maronmaeda/minicar_parts/CAM_MOUNT_D455_余力有版.stl

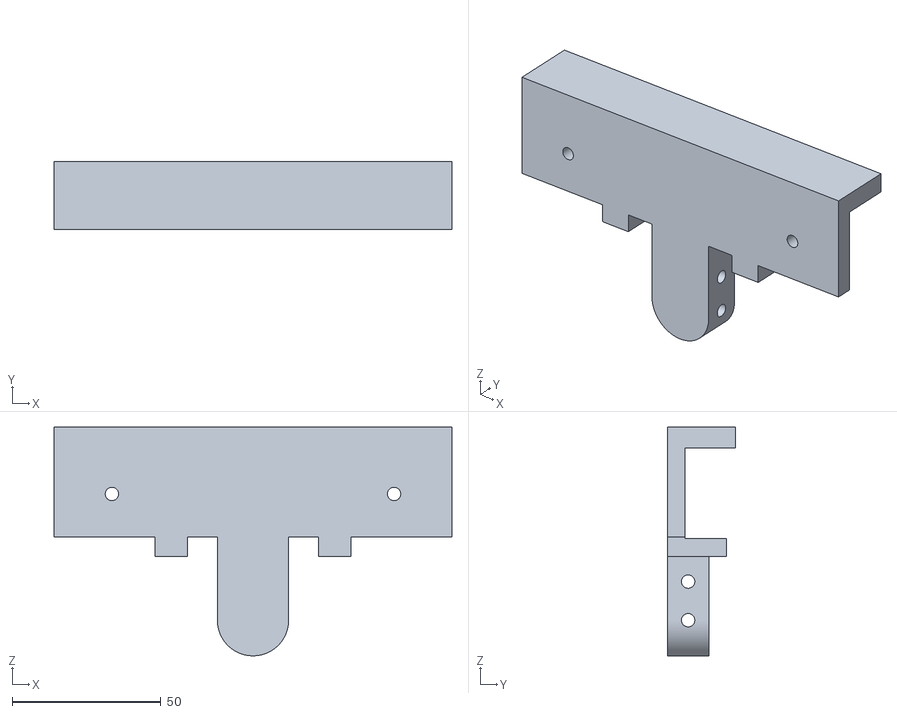
[picture p1: CAD file, 2026-09-10]
CAM_MOUNT_D455_余力有版.stl
134.0 x 23.0 x 77.0
