maronmaeda/minicar_parts/parts/01_TOWER.FCStd

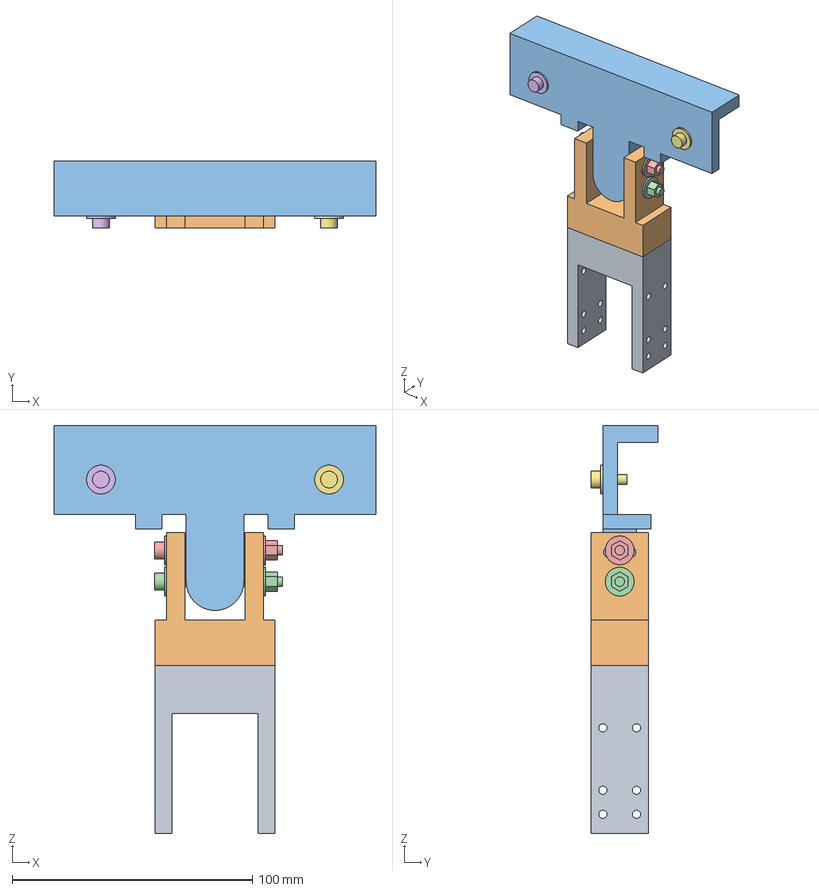
[picture p2: CAD file, 2026-09-10]
parts/01_TOWER.FCStd
134.0 x 28.0 x 169.9 mm
TOWER_タワー本体
REF_ADJUSTER_参照_印刷対象外
REF_CAM_MOUNT_参照_印刷対象外
REF_回転軸_M4x40_印刷対象外
REF_クランプ_M4x40_印刷対象外
REF_カメラ左_M4x10_印刷対象外
REF_カメラ右_M4x10_印刷対象外
