maronmaeda/minicar_parts/parts/_backup/01_TOWER.20260910-202742.FCStd

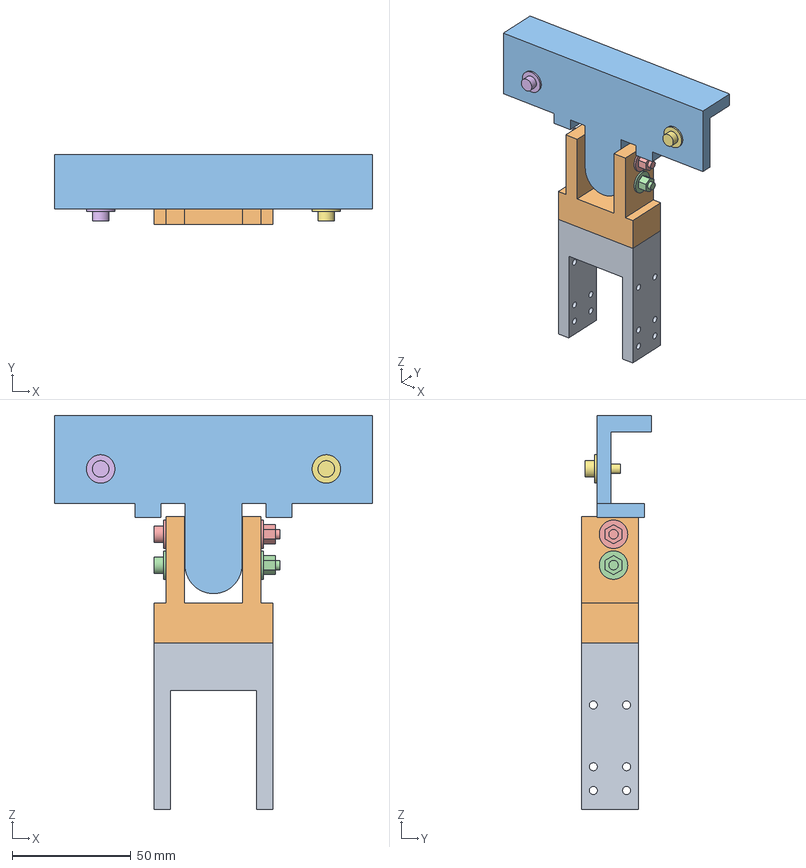
[picture p3: CAD file, 2026-09-10]
parts/_backup/01_TOWER.20260910-202742.FCStd
134.0 x 29.5 x 165.9 mm
TOWER_タワー本体
REF_ADJUSTER_参照_印刷対象外
REF_CAM_MOUNT_参照_印刷対象外
REF_回転軸_M4x40_印刷対象外
REF_クランプ_M4x40_印刷対象外
REF_カメラ左_M4x10_印刷対象外
REF_カメラ右_M4x10_印刷対象外
