maronmaeda/minicar_parts/parts/_backup/01_TOWER.20260910-061634.FCStd

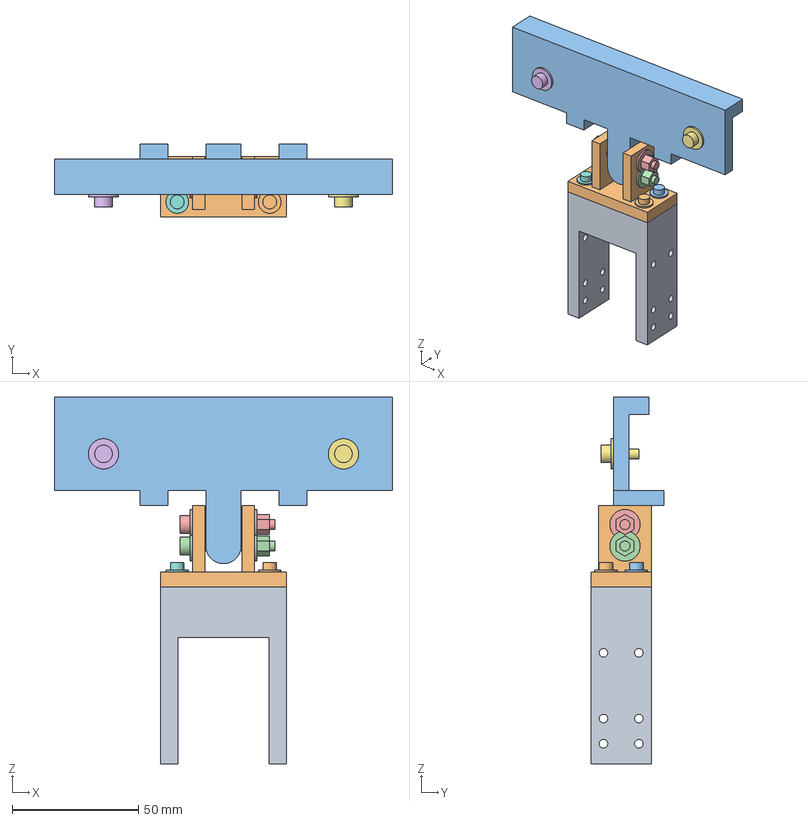
[picture p5: CAD file, 2026-09-10]
parts/_backup/01_TOWER.20260910-061634.FCStd
134.0 x 29.0 x 145.3 mm
TOWER_タワー本体
REF_ADJUSTER_参照_印刷対象外
REF_CAM_MOUNT_参照_印刷対象外
REF_回転軸_M4x40_印刷対象外
REF_クランプ_M4x40_印刷対象外
REF_カメラ左_M4x10_印刷対象外
REF_カメラ右_M4x10_印刷対象外
REF_タワー固定_M3x12_印刷対象外
REF_タワー固定_M3x12_印刷対象外001
REF_タワー固定_M3x12_印刷対象外002
REF_タワー固定_M3x12_印刷対象外003
