maronmaeda/minicar_parts/stl/TOWER_ADJ_印刷用.stl

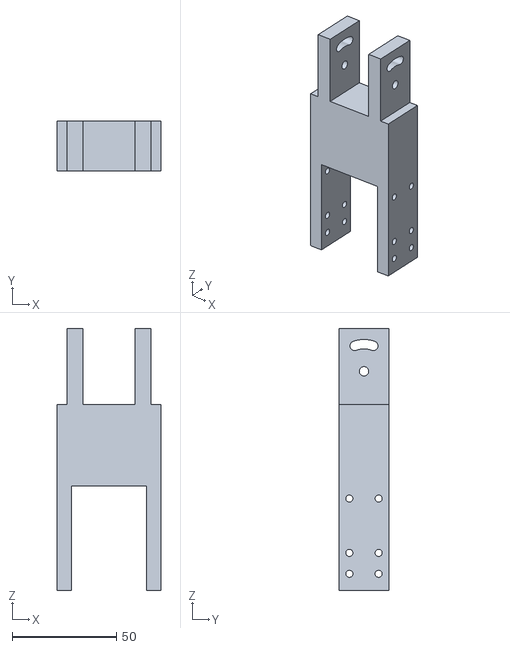
[picture p6: CAD file, 2026-09-10]
stl/TOWER_ADJ_印刷用.stl
50.0 x 24.0 x 125.4
