maronmaeda/minicar_parts/タワー.FCStd

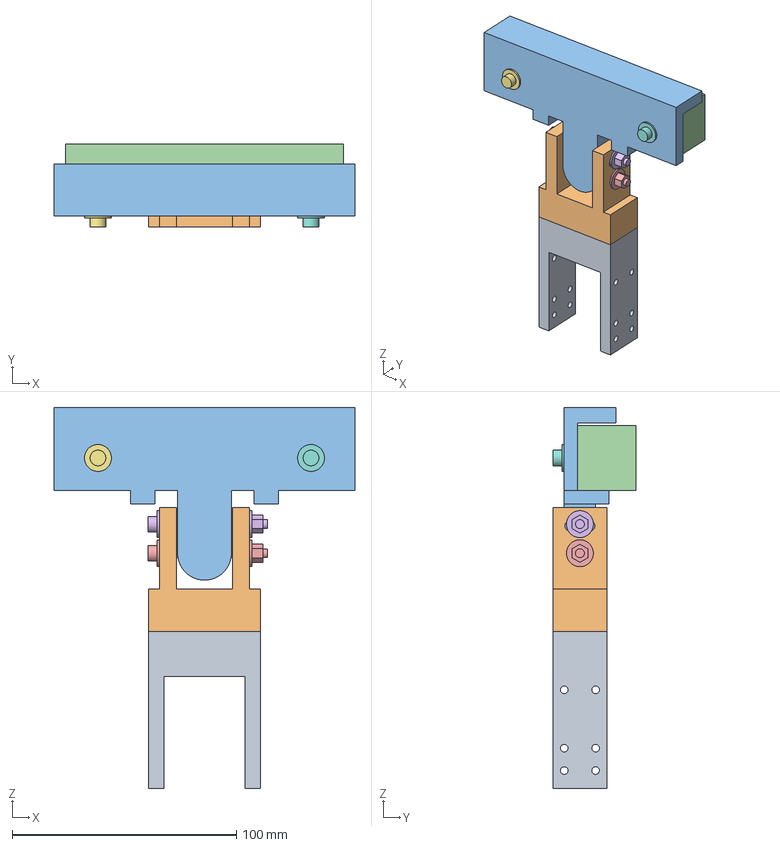
[picture p7: CAD file, 2026-09-10]
タワー.FCStd
134.0 x 37.0 x 169.9 mm
TOWER_タワー本体
ADJUSTER_ピッチ調整
CAM_MOUNT_D455
D455_参照外形_印刷対象外
REF_回転軸_M4x40_印刷対象外
REF_クランプ_M4x40_印刷対象外
REF_カメラ左_M4x10_印刷対象外
REF_カメラ右_M4x10_印刷対象外
