maronmaeda/minicar_parts/parts/_backup/04_TOWER_ADJ.20260910-202112.FCStd

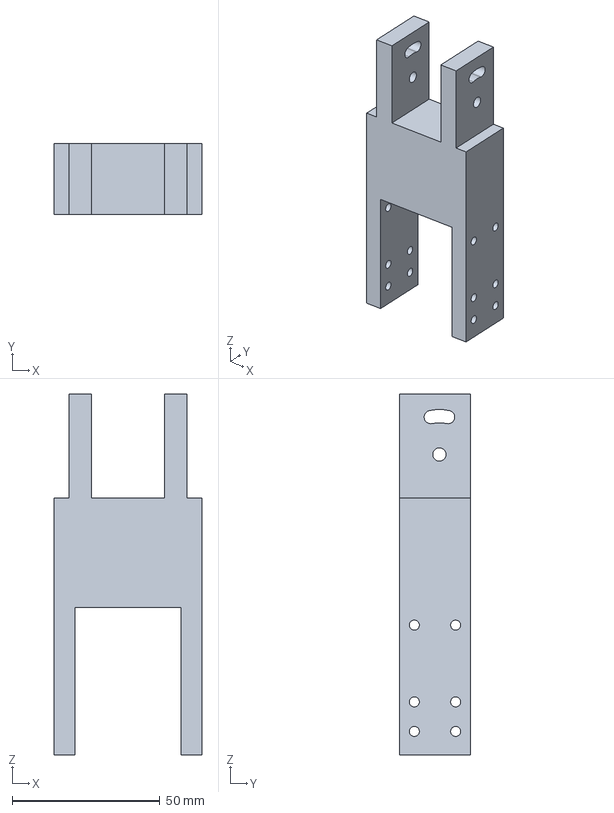
[picture p8: CAD file, 2026-09-10]
parts/_backup/04_TOWER_ADJ.20260910-202112.FCStd
50.0 x 24.0 x 122.3 mm
