maronmaeda/minicar_parts/タワー.backup-20260907-231259.FCStd

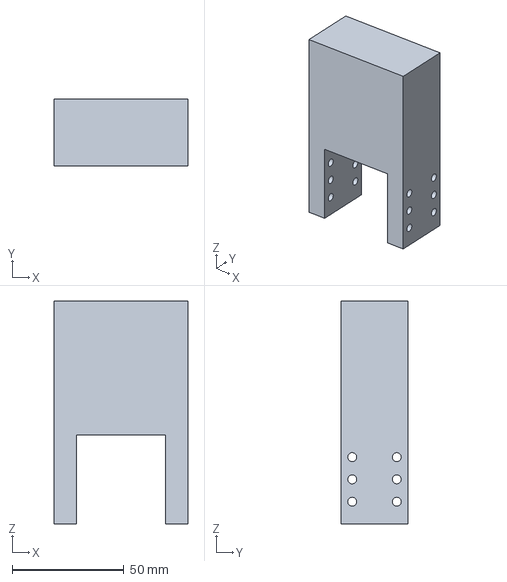
[picture p9: CAD file, 2026-09-10]
タワー.backup-20260907-231259.FCStd
60.0 x 30.0 x 100.0 mm
