maronmaeda/minicar_parts/parts/_backup/04_TOWER_ADJ.20260910-203938.FCStd

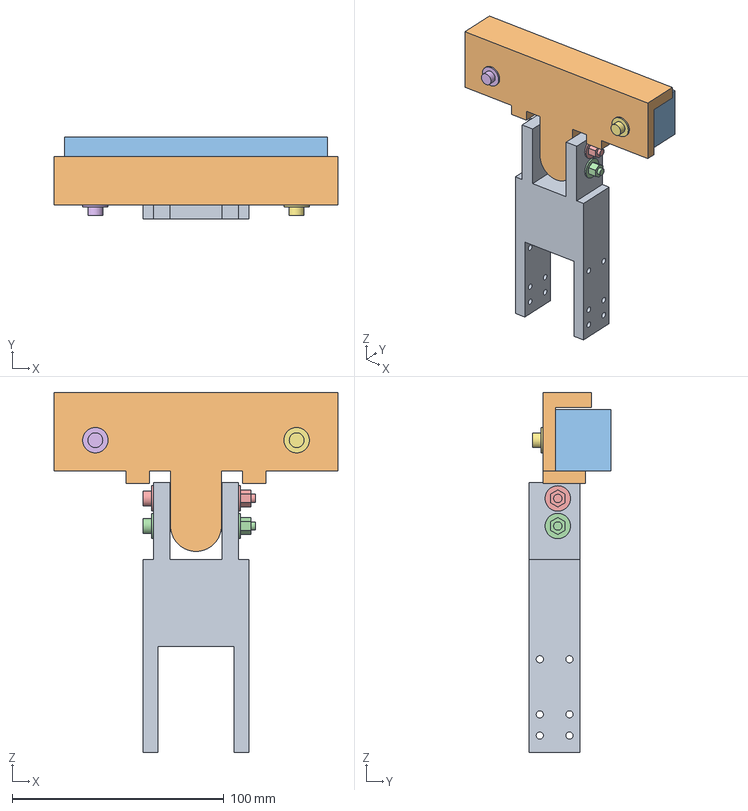
[picture p11: CAD file, 2026-09-10]
parts/_backup/04_TOWER_ADJ.20260910-203938.FCStd
134.0 x 38.5 x 169.9 mm
TOWER_ADJ_一体版
REF_CAM_MOUNT_参照_印刷対象外
REF_D455_参照外形_印刷対象外
REF_回転軸_M4x40_印刷対象外
REF_クランプ_M4x40_印刷対象外
REF_カメラ左_M4x10_印刷対象外
REF_カメラ右_M4x10_印刷対象外
