maronmaeda/minicar_parts/parts/_backup/03_CAM_MOUNT.20260910-203914.FCStd

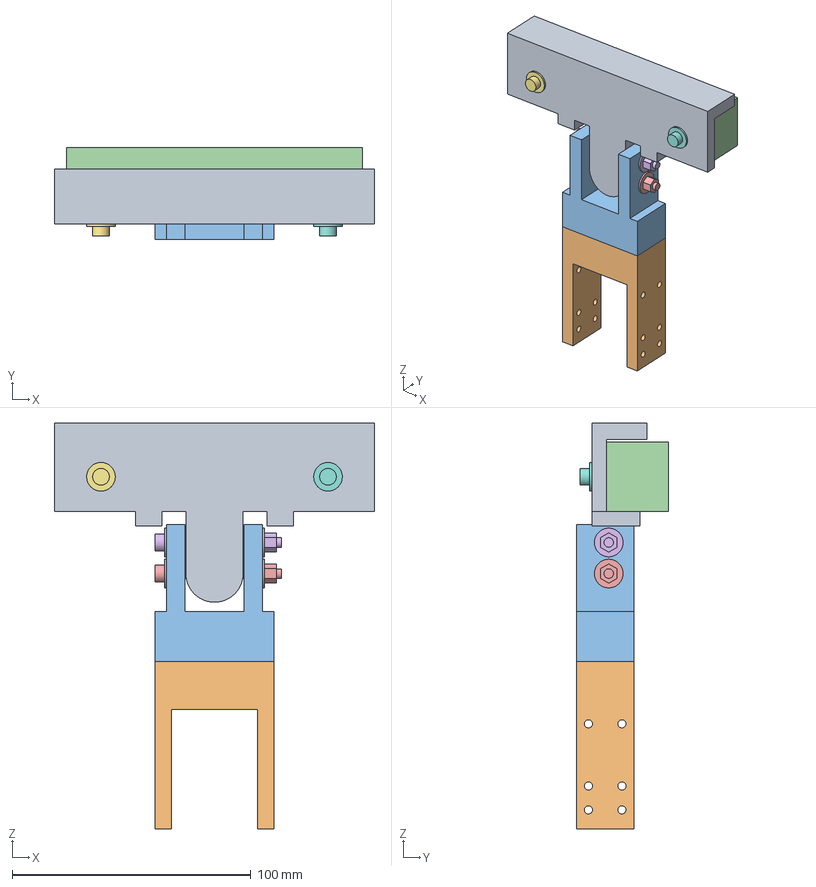
[picture p12: CAD file, 2026-09-10]
parts/_backup/03_CAM_MOUNT.20260910-203914.FCStd
134.0 x 38.5 x 169.9 mm
CAM_MOUNT_D455固定
REF_Body_参照_印刷対象外
REF_ADJUSTER_参照_印刷対象外
REF_D455_参照外形_印刷対象外
REF_回転軸_M4x40_印刷対象外
REF_クランプ_M4x40_印刷対象外
REF_カメラ左_M4x10_印刷対象外
REF_カメラ右_M4x10_印刷対象外
