maronmaeda/minicar_parts/parts/_backup/01_TOWER.20260908-215730.FCStd

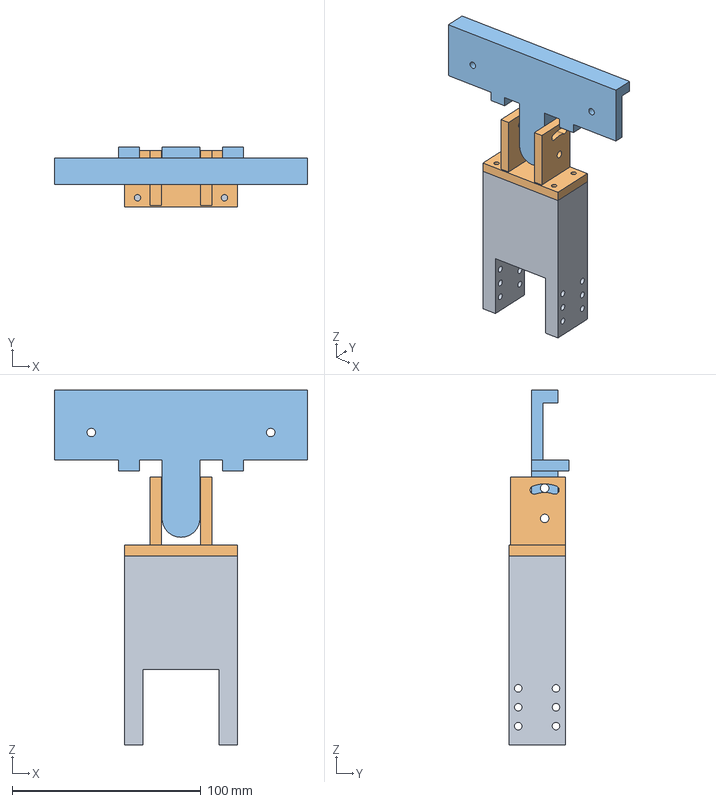
[picture p14: CAD file, 2026-09-10]
parts/_backup/01_TOWER.20260908-215730.FCStd
134.0 x 32.0 x 188.0 mm
TOWER_タワー本体
REF_ADJUSTER_参照_印刷対象外
REF_CAM_MOUNT_参照_印刷対象外
