maronmaeda/minicar_parts/parts/_backup/03_CAM_MOUNT.20260908-215732.FCStd

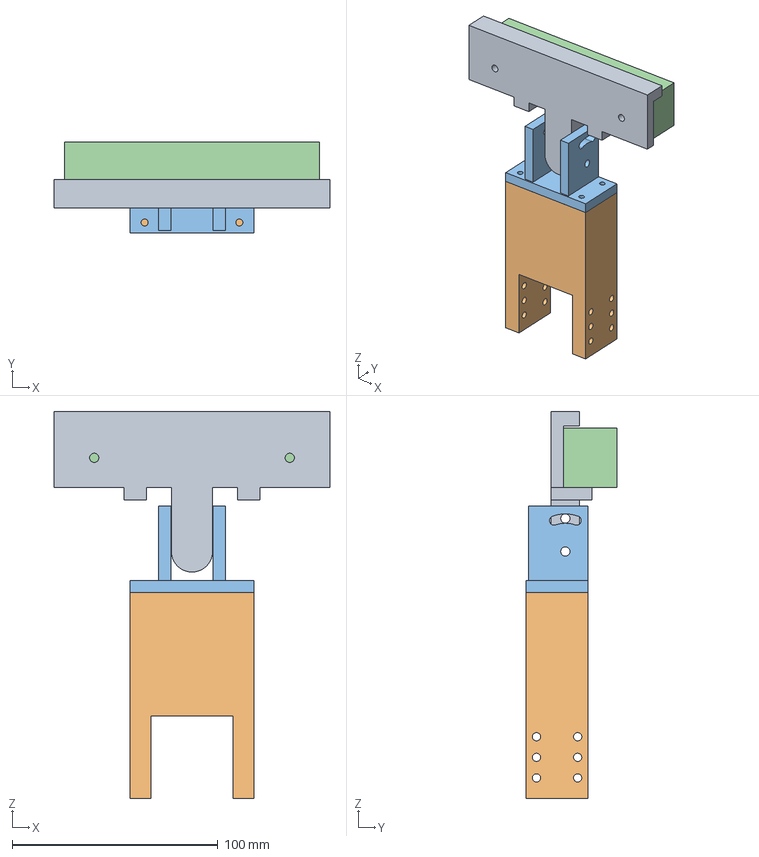
[picture p18: CAD file, 2026-09-10]
parts/_backup/03_CAM_MOUNT.20260908-215732.FCStd
134.0 x 44.0 x 188.0 mm
CAM_MOUNT_D455固定
REF_Body_参照_印刷対象外
REF_ADJUSTER_参照_印刷対象外
REF_D455_参照外形_印刷対象外
