maronmaeda/minicar_parts/parts/_backup/03_CAM_MOUNT.20260909-234717.FCStd

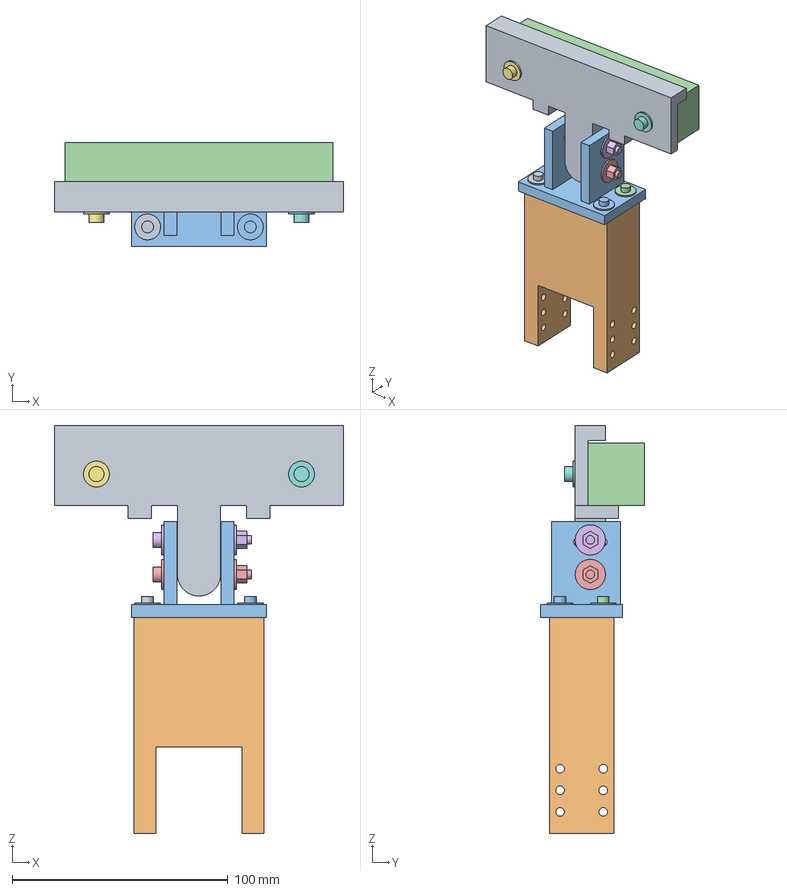
[picture p24: CAD file, 2026-09-10]
parts/_backup/03_CAM_MOUNT.20260909-234717.FCStd
134.0 x 48.0 x 189.0 mm
CAM_MOUNT_D455固定
REF_Body_参照_印刷対象外
REF_ADJUSTER_参照_印刷対象外
REF_D455_参照外形_印刷対象外
REF_回転軸_M4x40_印刷対象外
REF_クランプ_M4x40_印刷対象外
REF_カメラ左_M4x10_印刷対象外
REF_カメラ右_M4x10_印刷対象外
REF_タワー固定_M3x12_印刷対象外
REF_タワー固定_M3x12_印刷対象外001
REF_タワー固定_M3x12_印刷対象外002
REF_タワー固定_M3x12_印刷対象外003
