maronmaeda/minicar_parts/parts/_backup/01_TOWER.20260909-234716.FCStd

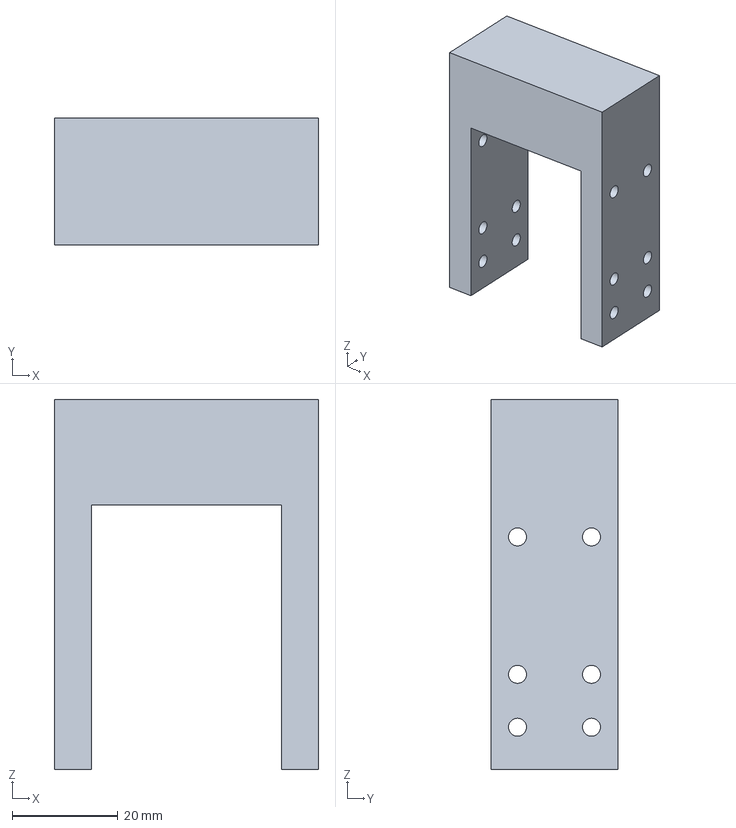
[picture p25: CAD file, 2026-09-10]
parts/_backup/01_TOWER.20260909-234716.FCStd
50.0 x 24.0 x 70.0 mm
