maronmaeda/minicar_parts/(list of files, cad)

Other CAD files:
ASSEMBLY.FCStd
stl/CAM_MOUNT_D455_印刷用.stl
parts/02_ADJUSTER.FCStd
parts/03_CAM_MOUNT.FCStd
タワー-BodySketch002.step
parts/_backup/03_CAM_MOUNT.20260910-210909.FCStd
parts/_backup/03_CAM_MOUNT.20260910-202743.FCStd
parts/_backup/02_ADJUSTER.20260910-210909.FCStd
parts/_backup/04_TOWER_ADJ.20260910-210938.FCStd
parts/_backup/03_CAM_MOUNT.20260910-202056.FCStd
parts/_backup/02_ADJUSTER.20260910-061635.FCStd
parts/_backup/01_TOWER.20260910-203913.FCStd
parts/_backup/03_CAM_MOUNT.20260910-194550.FCStd
parts/_backup/02_ADJUSTER.20260910-203913.FCStd
parts/_backup/02_ADJUSTER.20260908-215731.FCStd
parts/_backup/02_ADJUSTER.20260909-234717.FCStd
parts/_backup/03_CAM_MOUNT.20260910-200617.FCStd
parts/_backup/01_TOWER.20260910-210908.FCStd
parts/_backup/03_CAM_MOUNT.20260910-065311.FCStd
